Vincentbnguyen/ECE445-Submetering-ECEB/Houji_Zhou/first_version_pcb.webp

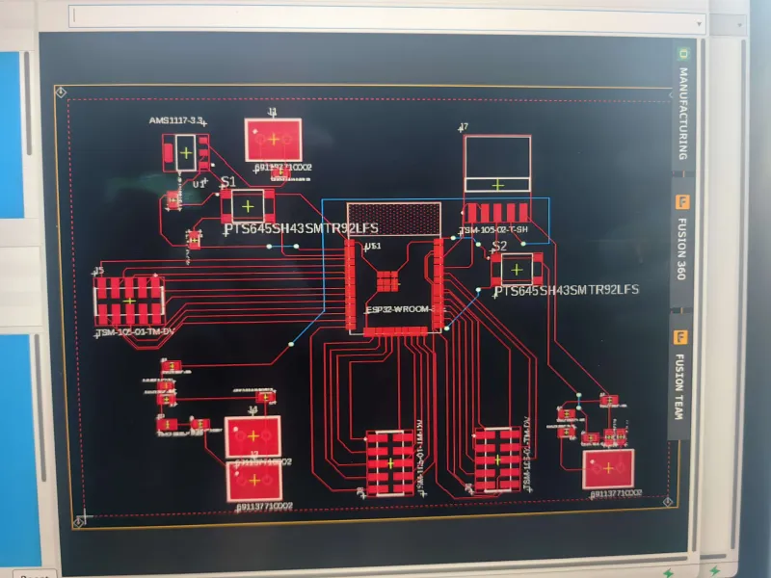
Houji_Zhou/first_version_pcb.webp
