Vincentbnguyen/ECE445-Submetering-ECEB/sd_module/sd_module.ino

#include "FS.h"
#include "SD.h"
#include <SPI.h>
//need certain data to be wrote into sc card
float data1;
float data2;
float data3;
float data4;
String dataMessage;

// NTP server to request epoch time
const char* ntpServer = "pool.ntp.org";

// Timer variables
unsigned long lastTime = 0;
unsigned long timerDelay = 30000;

// Variable to save current epoch time
unsigned long epochTime; 

// Initialize SD card
void initSDCard(){
   if (!SD.begin()) {
    Serial.println("Card Mount Failed");
    return;
  }
  uint8_t cardType = SD.cardType();

  if(cardType == CARD_NONE){
    Serial.println("No SD card attached");
    return;
  }
  Serial.print("SD Card Type: ");
  if(cardType == CARD_MMC){
    Serial.println("MMC");
  } else if(cardType == CARD_SD){
    Serial.println("SDSC");
  } else if(cardType == CARD_SDHC){
    Serial.println("SDHC");
  } else {
    Serial.println("UNKNOWN");
  }
  uint64_t cardSize = SD.cardSize() / (1024 * 1024);
  Serial.printf("SD Card Size: %lluMB\n", cardSize);
}

// Write to the SD card
void writeFile(fs::FS &fs, const char * path, const char * message) {
  Serial.printf("Writing file: %s\n", path);

  File file = fs.open(path, FILE_WRITE);
  if(!file) {
    Serial.println("Failed to open file for writing");
    return;
  }
  if(file.print(message)) {
    Serial.println("File written");
  } else {
    Serial.println("Write failed");
  }
  file.close();
}

// Append data to the SD card
void appendFile(fs::FS &fs, const char * path, const char * message) {
  Serial.printf("Appending to file: %s\n", path);

  File file = fs.open(path, FILE_APPEND);
  if(!file) {
    Serial.println("Failed to open file for appending");
    return;
  }
  if(file.print(message)) {
    Serial.println("Message appended");
  } else {
    Serial.println("Append failed");
  }
  file.close();
}

void setup() {

  initSDCard();
  // put your setup code here, to run once:
  File file = SD.open("/data.txt");
  if(!file) {
    Serial.println("File doesn't exist");
    Serial.println("Creating file...");
    writeFile(SD, "/data.txt", "data1, data2, data3, data4 \r\n");
  }
  else {
    Serial.println("File already exists");  
  }
  file.close();
}

void loop() {
  // put your main code here, to run repeatedly:
  if ((millis() - lastTime) > timerDelay) {
  //Concatenate all info separated by commas
    dataMessage = String(data1) + "," + String(data2) + "," + String(data3) + "," + String(data4)+ "\r\n";
    Serial.print("Saving data: ");
    Serial.println(dataMessage);
    //Append the data to file
    appendFile(SD, "/data.txt", dataMessage.c_str());

    lastTime = millis();
  }
}
