Vincentbnguyen/ECE445-Submetering-ECEB/ECE445_Telemetry/SerialLogger.h

// Copyright (c) Microsoft Corporation. All rights reserved.
// SPDX-License-Identifier: MIT

#ifndef SERIALLOGGER_H
#define SERIALLOGGER_H

#include <Arduino.h>

#ifndef SERIAL_LOGGER_BAUD_RATE
#define SERIAL_LOGGER_BAUD_RATE 250000
#endif

class SerialLogger
{
public:
  SerialLogger();
  void Info(String message);
  void Error(String message);
};

extern SerialLogger Logger;

#endif // SERIALLOGGER_H
