Vincentbnguyen/ECE445-Submetering-ECEB/(commit log)

2023-11-15 update MAIN to have 180 HZ sampling
2023-11-21 Accurate REAL and APP Power
