Vincentbnguyen/ECE445-Submetering-ECEB/Houji_Zhou/Final demo view.jpg

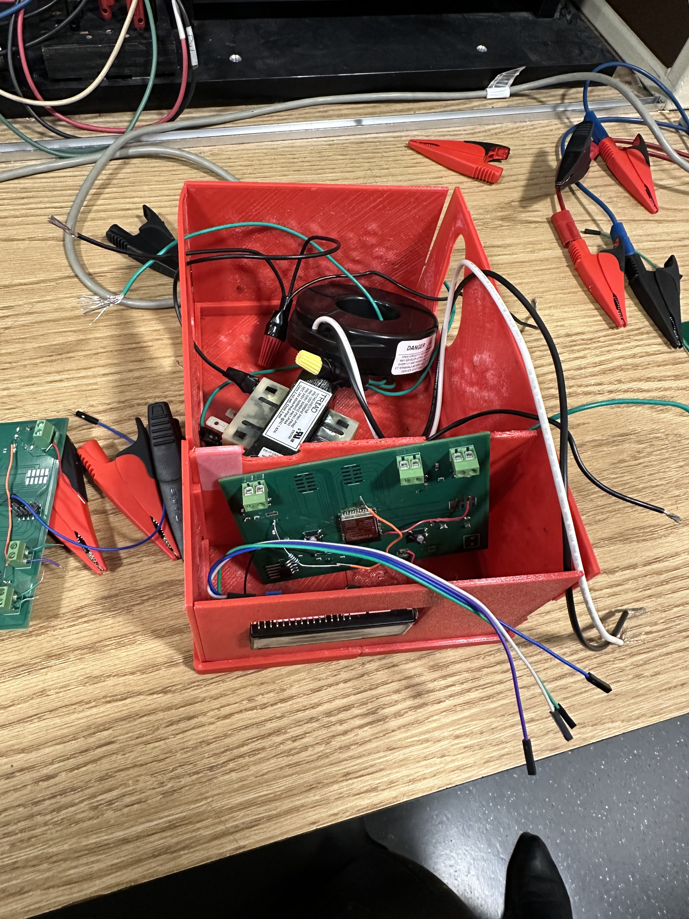
[picture p16: Houji_Zhou/Final demo view.jpg]
Houji_Zhou/Final demo view.jpg
